FedyaHenrichs-Tarasenkov/music-effects-practicum/schematic_files/Final_Schematic_and_Layout/20251211_150733.jpg

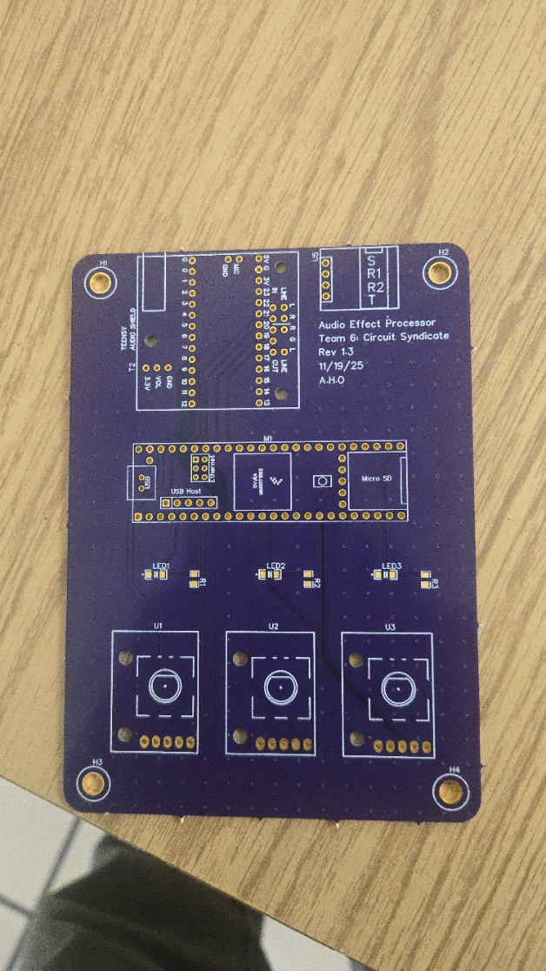
schematic_files/Final_Schematic_and_Layout/20251211_150733.jpg
