FedyaHenrichs-Tarasenkov/music-effects-practicum/DEMO/IMG_0477.jpeg

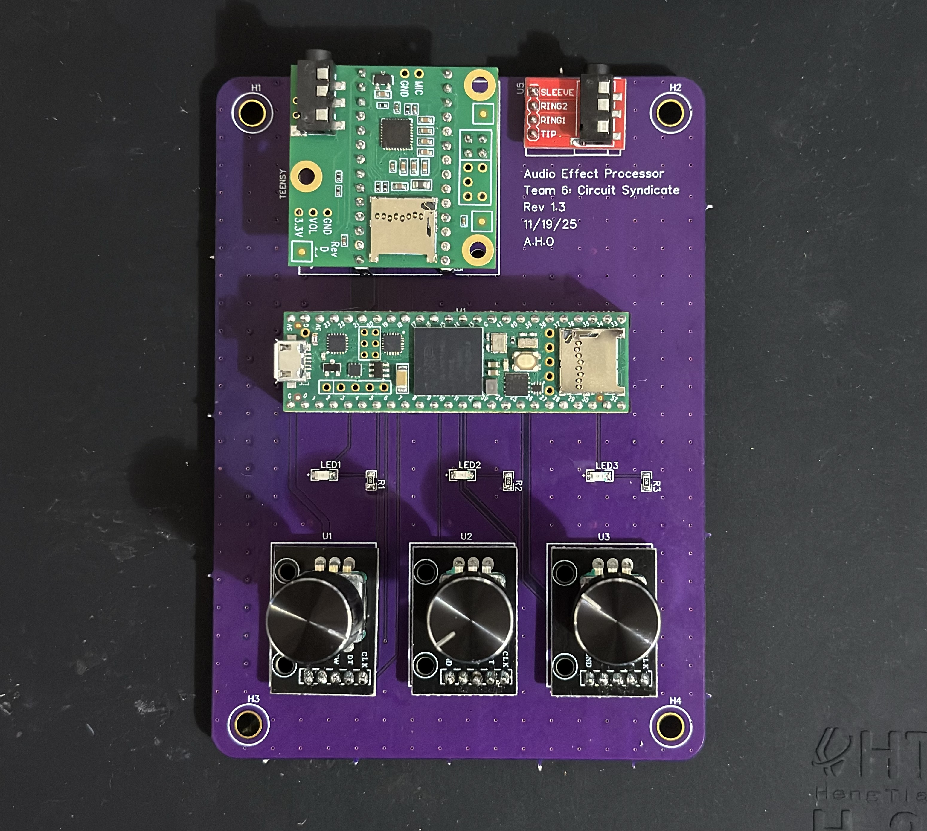
DEMO/IMG_0477.jpeg
