FedyaHenrichs-Tarasenkov/music-effects-practicum/README.md

# music-effects-practicum
ECE 411 Practicum project team 06. Fedya, Antonio, Rafael, Cesar
This project is a real-time music effects processor. Has a 3.5 mm aux input and output and allows the user to add different levels of reverb, bass boosting, and delay effects to the passed through audio signal.
