FedyaHenrichs-Tarasenkov/music-effects-practicum/DEMO/411 Practicum Slideshow.pdf

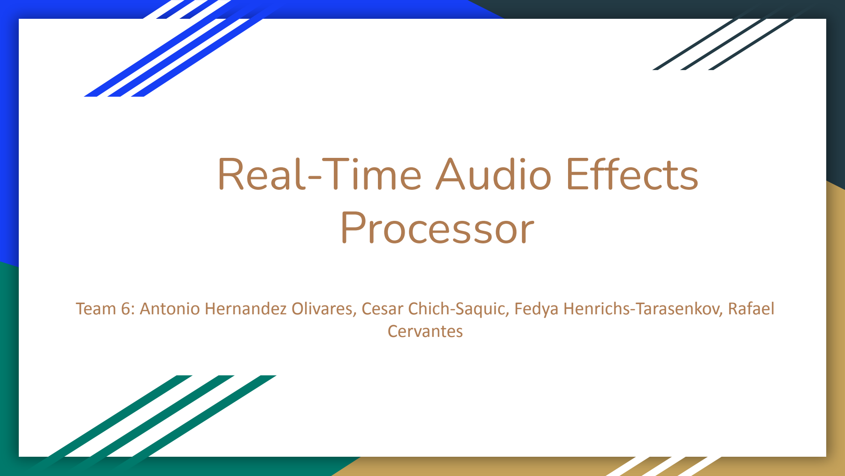
[picture p6: figure]
Real-Time Audio Effects Processor; Cervantes

### Team 6: Antonio Hernandez Olivares, Cesar Chich-Saquic, Fedya Henrichs-Tarasenkov, Rafael

# Background

- Problem: Most audio effects require expensive hardware or complex software
- Current Solutions:
- Professional rack units ($500-$2000),
- Software plugins (need computer)
- Overall limited consumer options with poor quality
- Gap: No current affordable, stand-alone, user-friendly solution
- Motivation:
- Make audio processing more available for hobbyists
- Educational tool for DSP concepts
- Enable personalized music experience

# Concept of Operations

- Setup: Connect an audio source via 3.5 mm audio jack to the input of the effects box and connect the output of the box to headphones or a speaker via 3.5 mm audio jack (AUX cord)
- Operation:
- Click encoder buttons to toggle chosen effects
- Rotate encoders to adjust strength
- LEDs indicate active effects
- Use Cases:
- Personal music enhancement
- Live instrument processing

# Objectives & Requirements

- Objectives:
- Design and build a system that will be able to convert an audio signal by adding various audio effects of our choosing
- Requirements:
- Must: be portable, pass through audio signal, have a clean and intuitive user interface, have at least 1 audio effect, have a case
- Should: have up to 3 audio effects
- May: have a screen displaying audio audio spectrum

# L0 Block Diagram

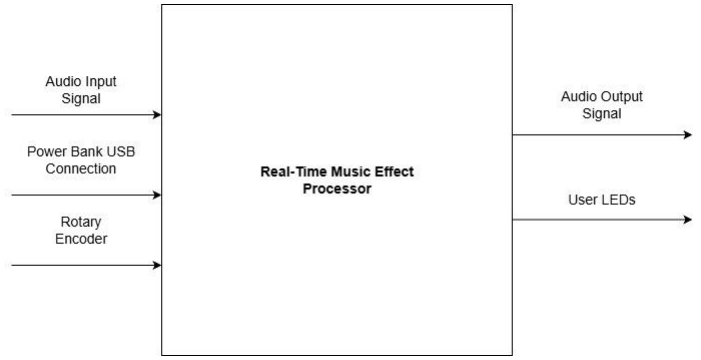
[picture p7: figure]

# L1 Block Diagram

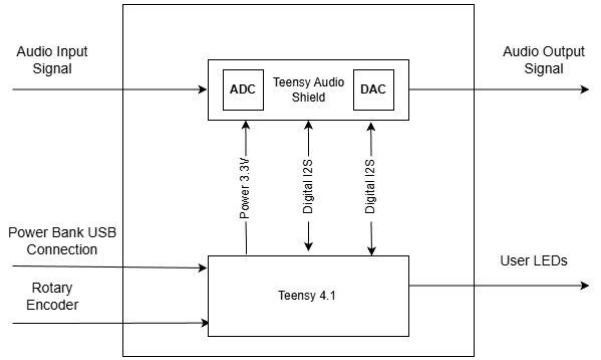
[picture p8: figure]

# Hardware Implementation

Schematics, board layout, tools used

- Power distribution
- We have a battery pack to provide 5V via USB
- Grounding planes
- Flooded ground planes on both sides of PCB
- Audio Shield wiring, I2S and I2C
- Audio shield and Teensy 4.1 wired together like they were stacked on top of each other. They need I2S for audio signal and I2C for digital communication between the audio shield and Teensy
- The Audio shield uses I2S with the Teensy 4.1 to convert incoming audio with the build in ADC, then converts the output with its DAC.
- Encoders and LEDs for user menu
- Encoders function as both our switch and knob. LEDs wired to signal which effects are on
- EasyEDA instead of KiCAD
- EasyEDA allows for contribution on the website instead of having to share a file like on KiCAD

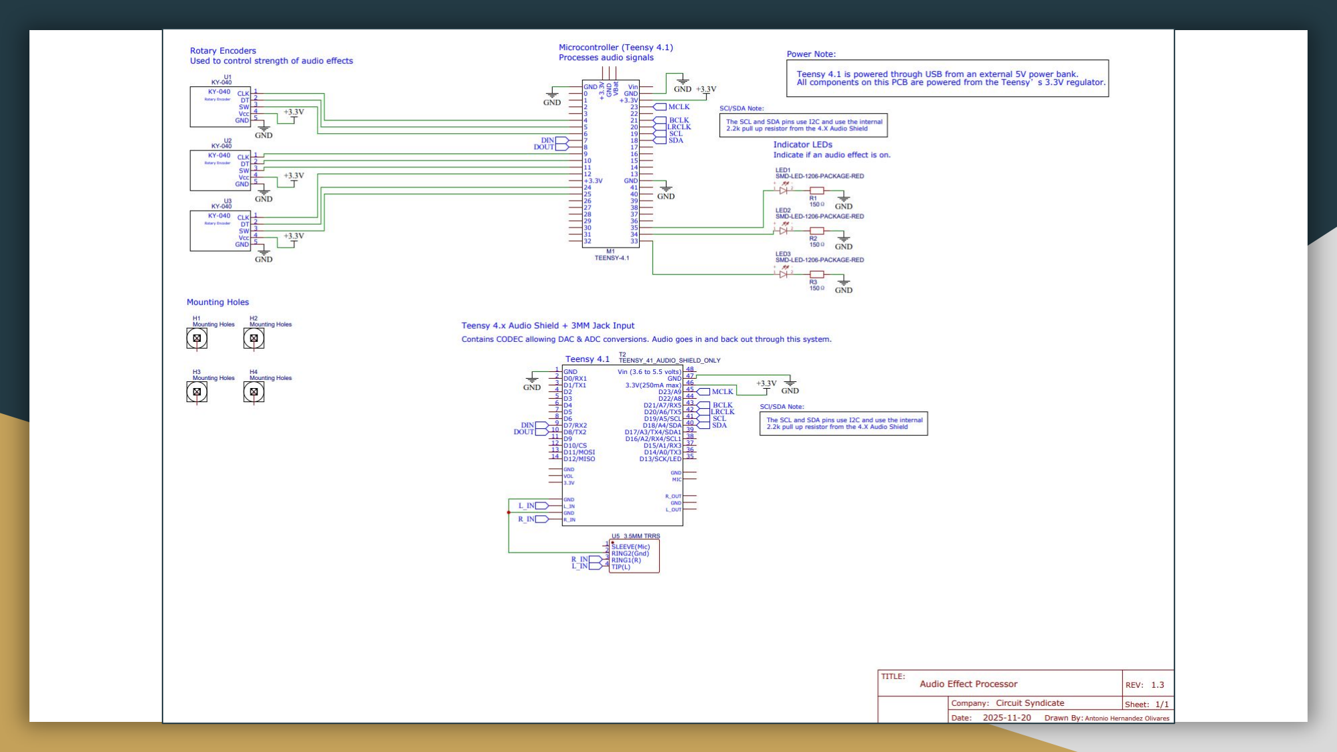
[picture p9: page 8]
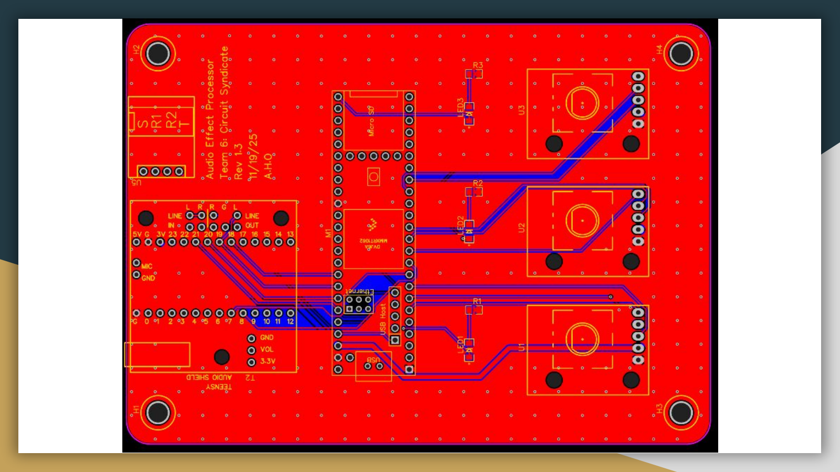
[picture p10: page 9]

# Bill of Materials

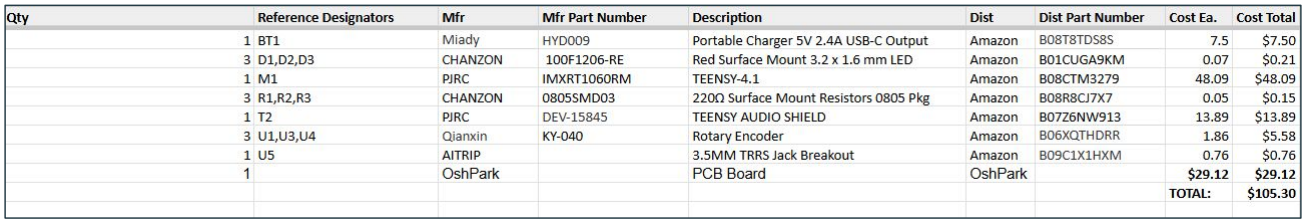
[picture p11: figure]

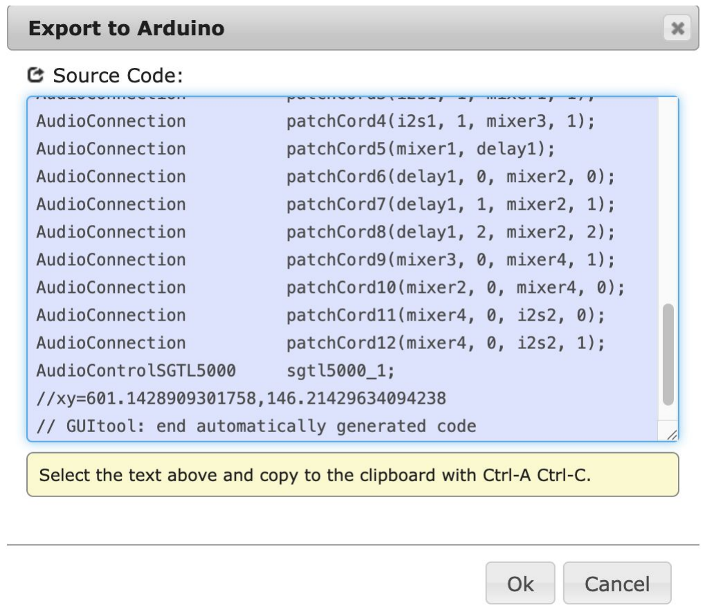
[picture p12: figure]

# Software Implementation

Key Libraries Used:

- Teensy Audio Library
- Pre-built DSP components (no DSP algorithms written from scratch)
- Visual design tool for drag-and-drop signal routing
- Built in effects like delay, reverb, and bass boost
- Handles 16-bit, 44.1 kHz streaming audio
- KY-040 Encoder Library
- Interrupt-driven for responsive control
and preventing false readings

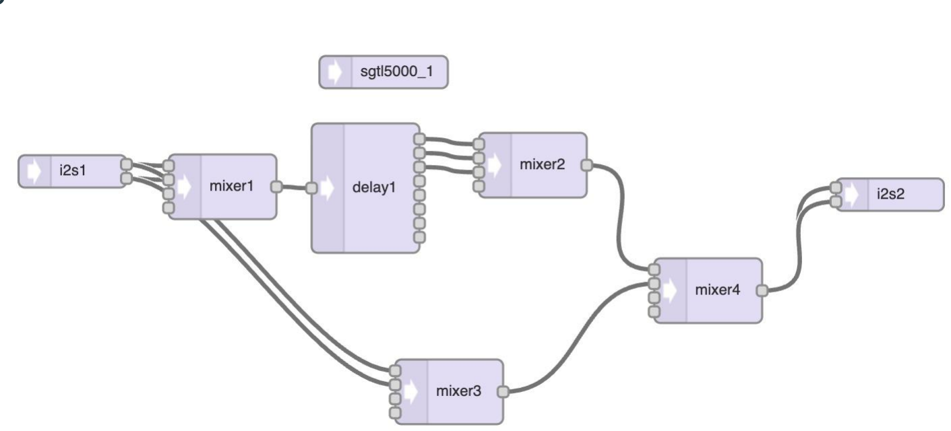
[picture p13: figure]

Software Implementation Cont.

Main Loop Structure:

- For each of the three encoders, the program:
- Checks if encoder value changed (parameter adjustment)
- Updates effect if it’s currently active
- Monitors button press (enable/disable effect)
- Updates LED status
Effect Control: | Effect | Parameter | Encoder Range
Bass Boost | Level | 0.85-1.0
Reverb | Room Size | 0.8-1.0
Delay | Time (base) | 300-800ms

Software Implementation Cont.

Key Features:

- Interrupt-driven encoders: Responsive, no missed turns or false readings
- Button debouncing: 200ms lockout prevents accidental toggles
- Parameter reset: Effects start at default values when enabled
- Surround sound: Always-on 3D audio enhancement

# IP and Prior Work

- GNU General Public License v3.0
- Ensures our work remains open source
- Included with all source code, schematics and documentation
- Third Party IP used:
1. Teensy Audio Library (MIT License): Audio processing framework
2. Arduino/Teensyduino (LGPL): Development Platform
3. Teensyduino Example Code (LGPL): Used pre-made example code as our base for hardware testing and learning how to use different functions from the library
4. KY-040 Library: Used for interrupt control

# Testing

- Methodology:
- Unit Testing: Individual effect algorithms
- Integration Testing: Full audio pipeline
- User Testing: Interface usability (encoders, LEDs)
- Results:
- Each effect worked as expected, integration through changing audio connection setup within code, encoders worked with both click and rotate functionality

# Results

- What Worked:
- Real-time performance: no audio dropouts
- Audio quality
- Challenges:
- Audio Noise: Proper grounding and power filtering caps
- Dynamic audio routing: Mixer-based transitions
- Cost about $100

# Contributions

Antonio Hernandez Olivares

- Circuit Schematic Design
- PCB Layout Design
- Software Development

Cesar Chich-Saquic

- Documentation
- PCB Testing
- PCB Assembly

Fedya Henrichs-Tarasenkov

- Software Testing
- Breadboard Testing
- PCB Testing
- Documentation

Rafael Cervantes

- Documentation
- PCB Layout Design
- Circuit Schematic Design

# Lessons Learned

Team Lessons Learned

### - PCB Design - PCB Testing - Team Collaboration - How to use github - Practice schematic design

Individual Lessons Learned

- Fedya:
- Github repo
construction/organization
- Testing- unit, bottom-up
- Teensy audio library
- Rafael:
- EasyEDA
- Cesar:
- PCB testing and assembly
- Team Collaboration and organization
- Antonio:
- Buy Chinese. No OSH Park.
- Ground planes with via stitching

# Demo and Questions

https://github.com/FedyaHenrichs-Tarasenkov/music-effects-practicum/tree/main
