FedyaHenrichs-Tarasenkov/music-effects-practicum/prototype/20251211_154828.jpg

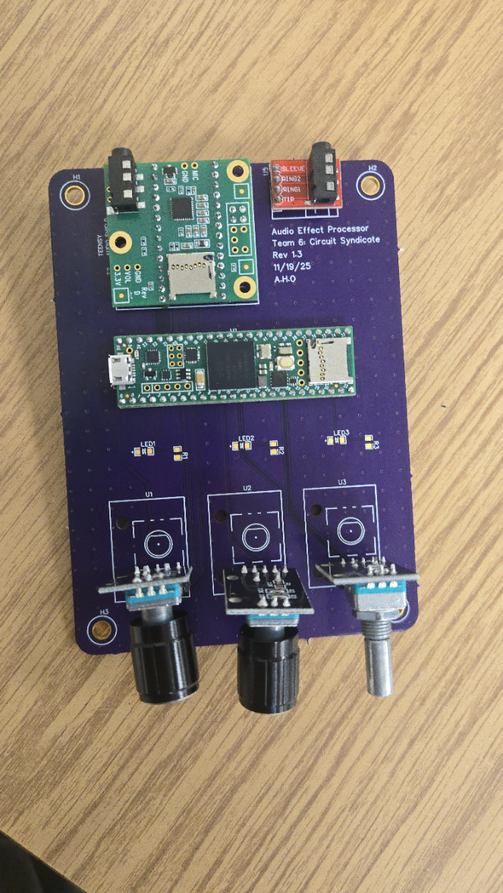
prototype/20251211_154828.jpg
