FedyaHenrichs-Tarasenkov/music-effects-practicum/prototype/20251212_110629.jpg

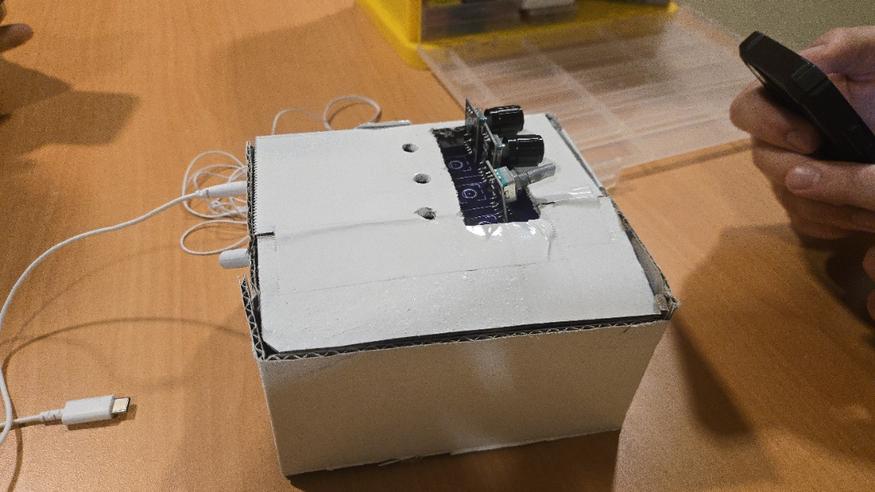
prototype/20251212_110629.jpg
