FedyaHenrichs-Tarasenkov/music-effects-practicum/DOCS/Team 6 - Bill of Materials.xlsx

Bill Of Materials for: 6 Circuit Syndicate
Last modified: 2025-11-12
PCB version: 1.1
BOM revision: 1 | 1
Qty | Reference Designators | Mfr | Mfr Part Number | Description | Dist | Dist Part Number | Cost Ea. | Cost Total
1 | BT1 | Miady | HYD009 | Portable Charger 5V 2.4A USB-C Output | Amazon | B08T8TDS8S | 7.5 | $7.50
3 | D1,D2,D3 | CHANZON | 100F5T-YT-WH-RE | Red 5mm LED | Amazon | B01AUI4WC8 | 0.08 | $0.24
1 | M1 | PJRC | IMXRT1060RM | TEENSY-4.1 | Amazon | B08CTM3279 | 48.09 | $48.09
3 | R1,R2,R3 | CHANZON | 0805SMD03 | 220Ω Surface Mount Resistors 0805 Pkg | Amazon | B08R8CJ7X7 | 0.05 | $0.15
3 | S1,S2,S3 | Taiss | MTS-101 | TOGGLE SWITCH 2 POSITIONS | Amazon | B0799LBFNY | 0.8 | $2.40
1 | T2 | PJRC | DEV-15845 | TEENSY AUDIO SHIELD | Amazon | B07Z6NW913 | 13.89 | $13.89
3 | U1,U3,U4 | Qianxin | KY-040 | Rotary Encoder | Amazon | B06XQTHDRR | 1.86 | $5.58
1 | U5 | AITRIP |  | 3.5MM TRRS Jack Breakout | Amazon | B09C1X1HXM | 0.76 | $0.76
 |  |  |  |  |  |  | TOTAL: | $78.61
VERSION INFO
Rev | Date
1.0r1 | 2025-11-12
