FedyaHenrichs-Tarasenkov/music-effects-practicum/schematic_files/Prelim_schematic/UpdatedBoardSchematic.pdf

# M1GND VBat

## Power Supply

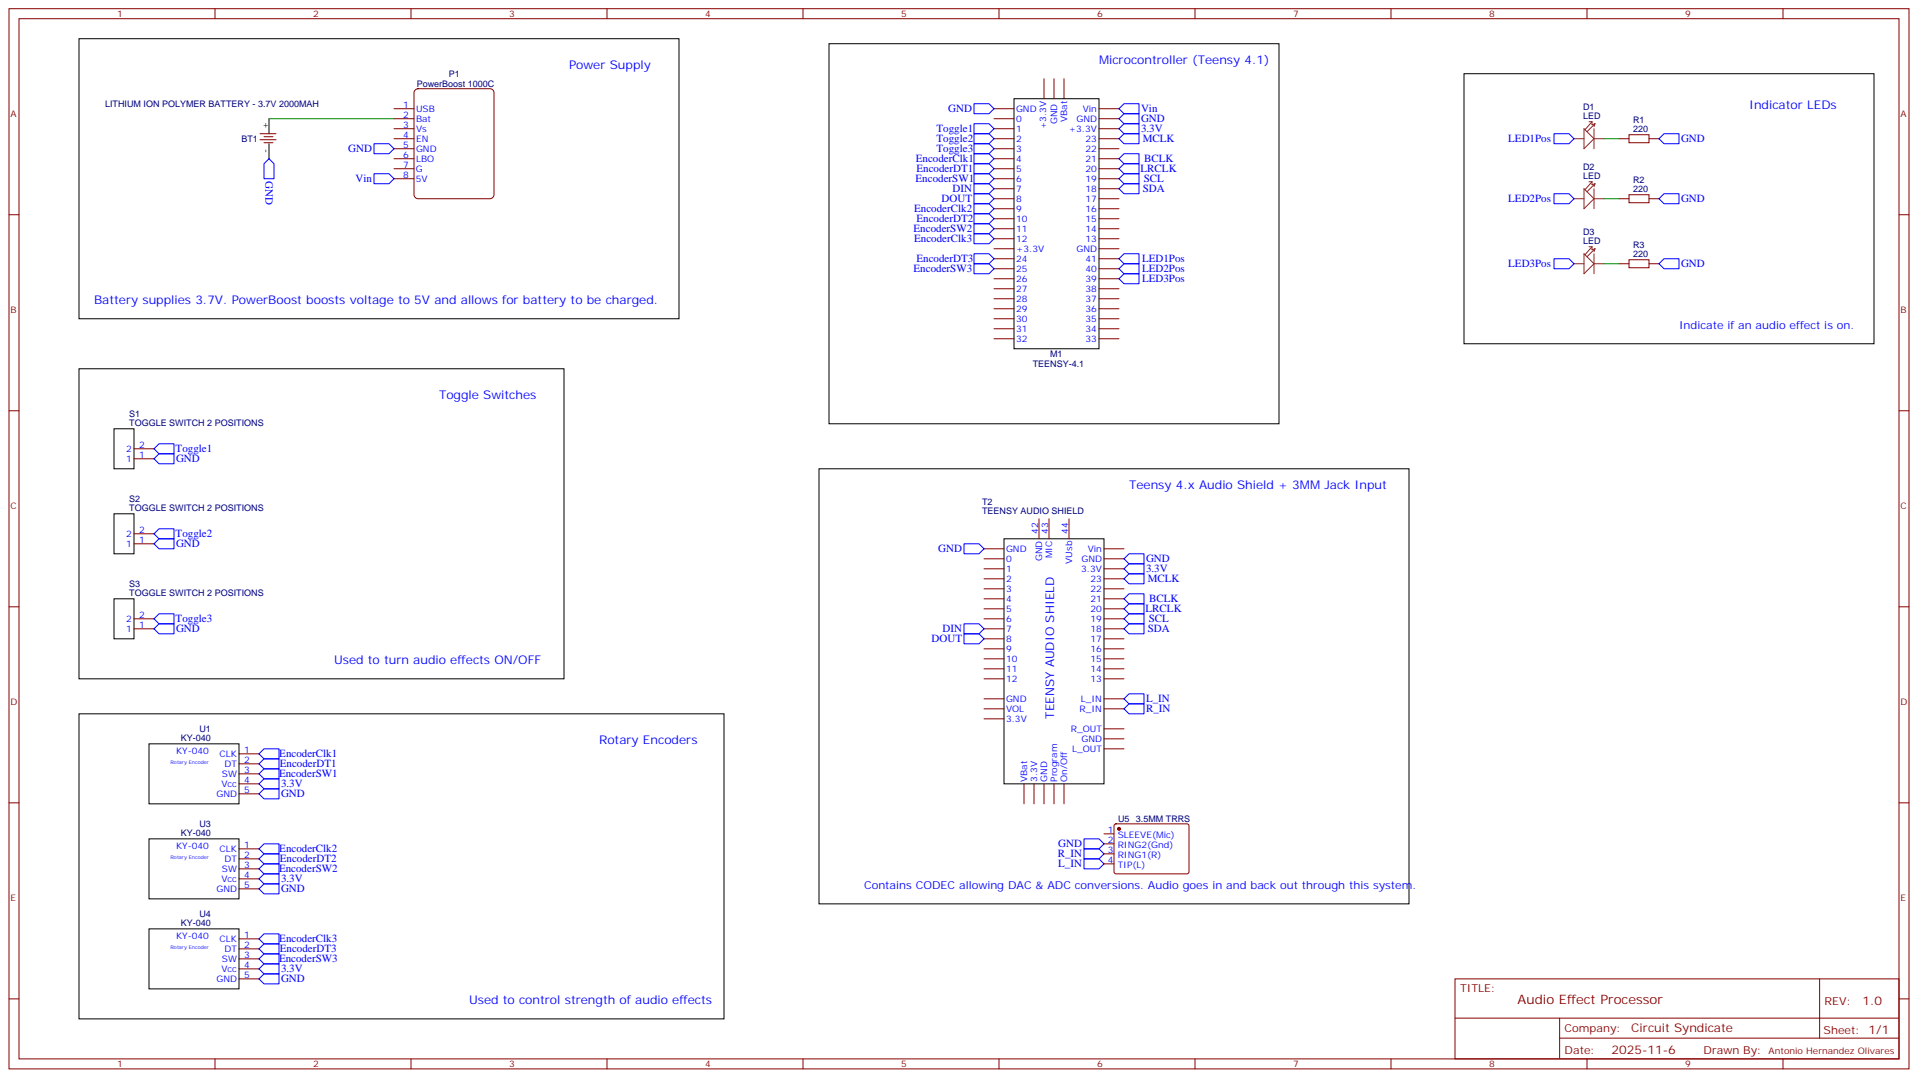
[picture p19: page 1]

GND LITHIUM ION POLYMER BATTERY - 3.7V 2000MAH

Battery supplies 3.7V. PowerBoost boosts voltage to 5V and allows for battery to be charged.

Indicate if an audio effect is on.

Teensy 4.x Audio Shield + 3MM Jack Input

Used to turn audio effects ON/OFF

Contains CODEC allowing DAC & ADC conversions. Audio goes in and back out through this system.

Used to control strength of audio effects

Drawn By: Antonio Hernandez Olivares
