FedyaHenrichs-Tarasenkov/music-effects-practicum/schematic_files/Prelim_schematic/Schematic.pdf

# M1GND VBat

## Toggle Switches

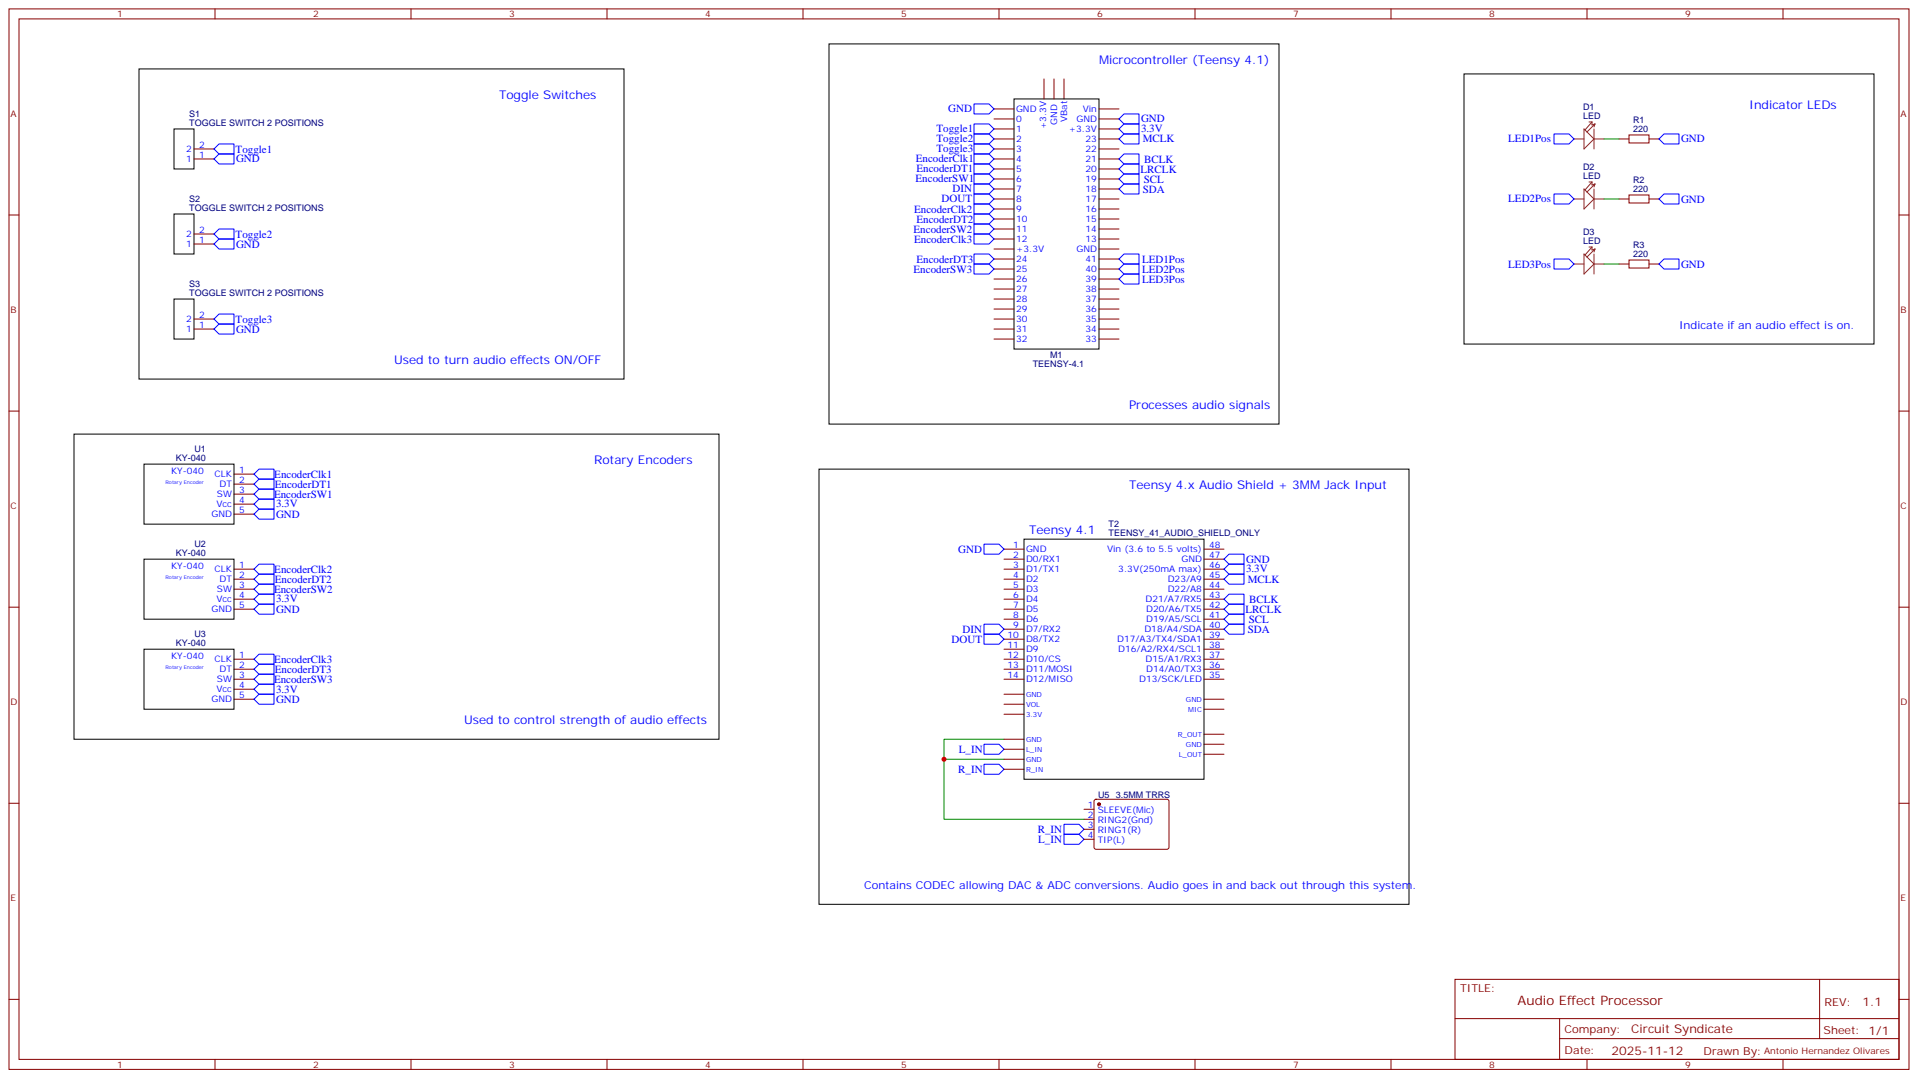
[picture p20: page 1]

Indicate if an audio effect is on.

Used to turn audio effects ON/OFF

Teensy 4.x Audio Shield + 3MM Jack Input

Used to control strength of audio effects

Contains CODEC allowing DAC & ADC conversions. Audio goes in and back out through this system.

Drawn By: Antonio Hernandez Olivares
