FedyaHenrichs-Tarasenkov/music-effects-practicum/schematic_files/Prelim_schematic/PrelimBoardLayout.pdf

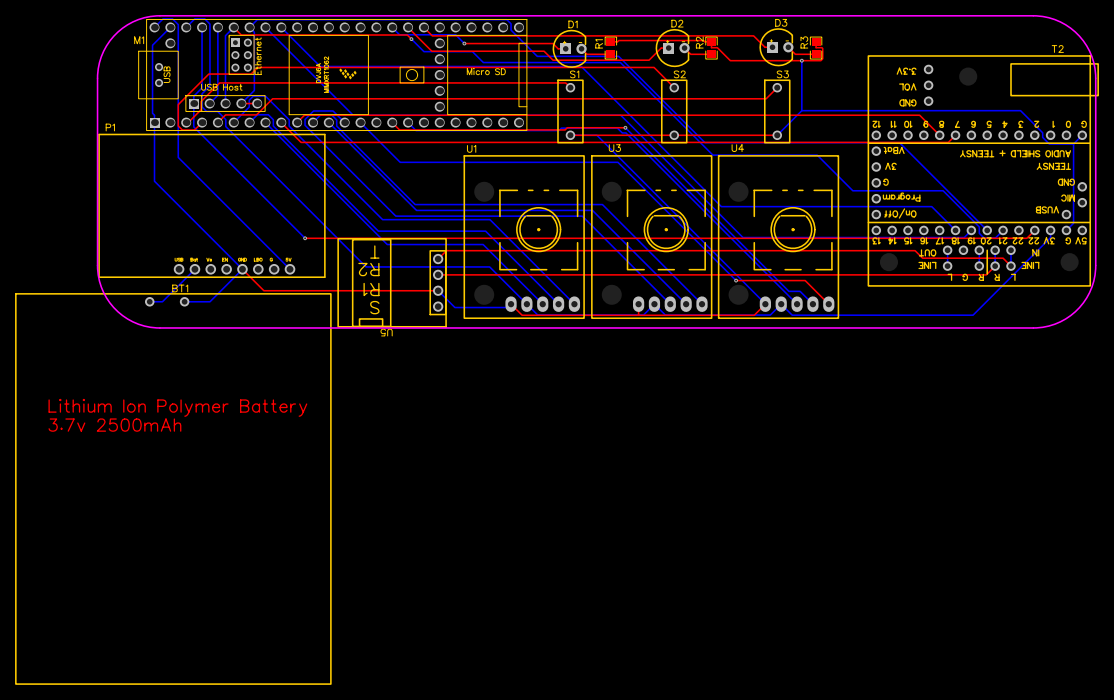
[picture p21: page 1]
