FedyaHenrichs-Tarasenkov/music-effects-practicum/schematic_files/Prelim_schematic/PCB_Layout.pdf

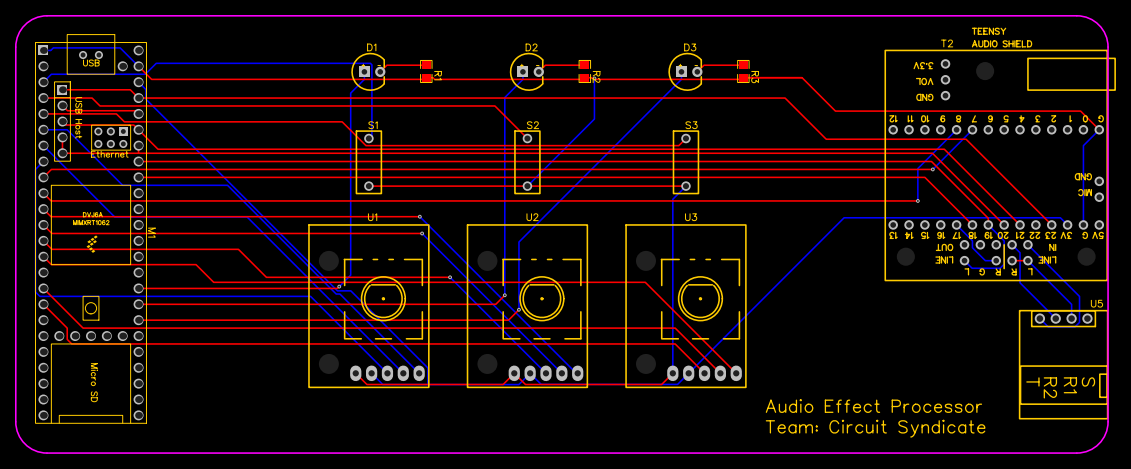
[picture p22: page 1]
