FedyaHenrichs-Tarasenkov/music-effects-practicum/schematic_files/Prelim_schematic/PCB Layout Rev1.2.pdf

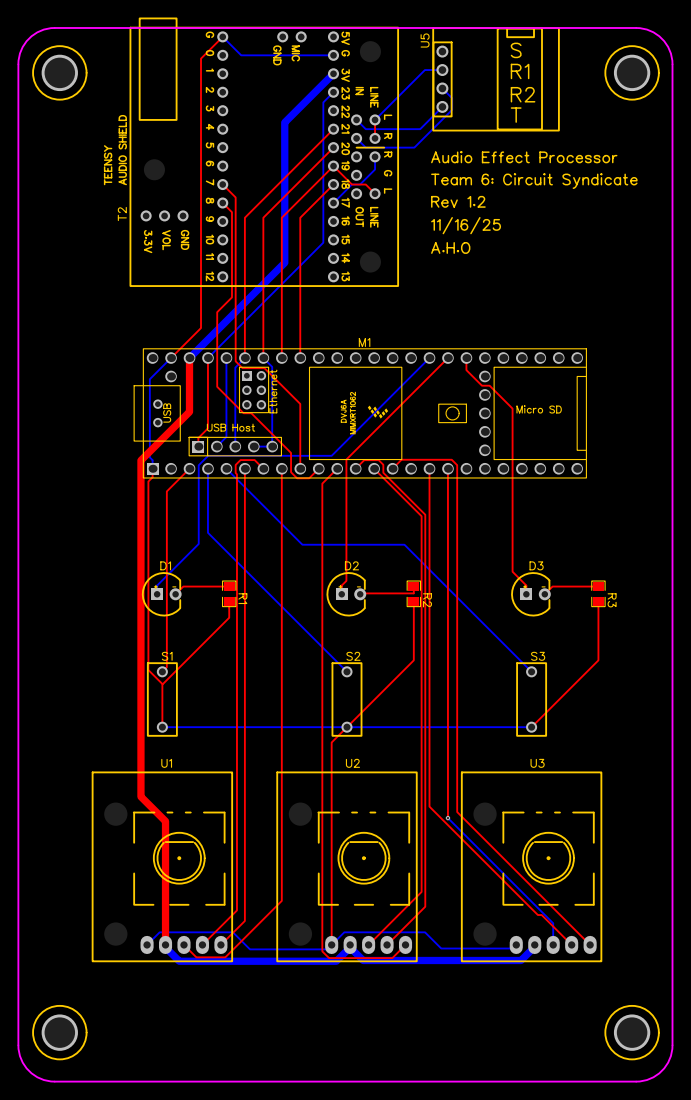
[picture p23: page 1]
