FedyaHenrichs-Tarasenkov/music-effects-practicum/(commit log)

2025-12-11 Rename Team 6 - Bill of Materials.xlsx to DOCS/Team 6 - Bill of Materials.xlsx
    Move file to DOCS folder
    [Team 6 - Bill of Materials.xlsx]
2025-12-11 Create placeholder
    Add a new folder to hold earlier versions of the schematic. We added changes via pdfs so that we could see them easier rather than just using the raw gerber files
2025-12-11 Rename schematic_files/PCB Layout Rev1.2.pdf to schematic_files/Prelim_schematic/PCB Layout Rev1.2.pdf
    Move to Prelim_schematic
2025-12-11 Rename schematic_files/PCB_Layout.pdf to schematic_files/Prelim_schematic/PCB_Layout.pdf
    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
2025-12-11 Rename schematic_files/PrelimBoardLayout.pdf to schematic_files/Prelim_schematic/PrelimBoardLayout.pdf
    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
2025-12-11 Rename schematic_files/PrelimSchematic.pdf to schematic_files/Prelim_schematic/PrelimSchematic.pdf
    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
2025-12-11 Rename schematic_files/Schematic.pdf to schematic_files/Prelim_schematic/Schematic.pdf
    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
2025-12-11 Rename schematic_files/UpdatedBoardSchematic.pdf to schematic_files/Prelim_schematic/UpdatedBoardSchematic.pdf
    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
2025-12-11 Update and rename software to proto_software
    Code for the breadboard prototype. This is just my final stuff for the breadboard but the actual final code used for the PCB will be added later by Antonio
2025-12-11 Assembled PCB
